sulhanfuadi/kawan-tunanetra/katana/katana.ino

/*
  KATANA (Kawan Tunanetra) - Smart Cane Prototype
  Target Board: Arduino Nano V3 (ATmega328P)

  Fitur Diagnosa Otomatis & Sensor Presence:
  - Mendeteksi secara langsung apakah sensor fisik terhubung (RIIL) atau terlepas (LEPAS).
  - Mencegah false alarm (misal alarm TEPI_TURUNAN tidak akan berbunyi jika sensor bawah memang belum dicolok).
  - Menampilkan status koneksi real-time setiap sensor di Serial Monitor.
*/

#include <Arduino.h>
#include <Wire.h>
#include <math.h>

// Set ke 0 untuk hardware fisik (Buzzer aktif 3-5V via transistor BC547)
// Set ke 1 jika simulasi di Wokwi
#define WOKWI_SIMULATION 0

// ================= PIN MAPPING =================
const byte PIN_FRONT_ECHO = 2;    // HC-SR04 Depan Echo
const byte PIN_FRONT_TRIG = 3;    // HC-SR04 Depan Trig
const byte PIN_FALL_TEST  = 4;    // Wokwi test button (D4 ke GND)
const byte PIN_VIBRATION  = 5;    // PWM Motor Getar SIG
const byte PIN_BUZZER     = 6;    // Active Buzzer via BC547 base
const byte PIN_DOWN_ECHO  = 8;    // HC-SR04 Bawah Echo
const byte PIN_DOWN_TRIG  = 9;    // HC-SR04 Bawah Trig
const byte PIN_WATER_RAW  = A0;   // Sensor Air Analog (A0)

const byte DEFAULT_MPU_ADDR = 0x68;   // Alamat I2C MPU6050 default (A4=SDA, A5=SCL)

// ================= PARAMETER AMBANG =================
const int FRONT_LOW_CM        = 100;
const int FRONT_MEDIUM_CM     = 60;
const int FRONT_NEAR_CM       = 30;
const int DOWN_DROP_THRESHOLD_CM = 45; // Ambang batas langsung sensor ke tanah (normal lantai ~25-38 cm, turunan/lubang > 45 cm)
const int WATER_LIMIT         = 400; // Diset ke 400 sesuai kalibrasi pengguna (ADC > 400 dianggap basah)
const float FALL_TILT_LIMIT_DEG = 45.0;
const unsigned long DROP_DEBOUNCE_MS = 200;
const unsigned long FALL_CONFIRM_MS  = 1200;

// Volume Buzzer PWM (0 - 255): Default 35 (~15% duty cycle, suara lembut dan tidak memekakkan telinga)
byte buzzerVolumePwm = 35;

enum AlertState {
  STANDBY,        // Sensor utama belum terpasang
  NORMAL,         // Semua sensor terpasang dan dalam batas aman
  OBJECT_LOW,     // Objek depan mulai terdeteksi (waspada)
  OBJECT_MEDIUM,  // Objek depan sedang
  OBJECT_NEAR,    // Objek depan sangat dekat (bahaya)
  WATER_ALERT,    // Genangan air / permukaan basah
  DROP_ALERT,     // Tepi turunan / lubang
  FALL_ALERT      // Tongkat jatuh / tergeletak
};

AlertState activeState = STANDBY;
unsigned long dropStartMs = 0;
unsigned long fallStartMs = 0;
unsigned long lastReportMs = 0;

// Data sensor & status koneksi hardware
bool frontConnected = false;
bool downConnected  = false;
bool mpuConnected   = false;
bool waterConnected = false;

// Konfigurasi Sensor Air Fisik (Pin A0)
// Diaktifkan default agar langsung membaca sensor air fisik tanpa perlu ketik WATER ON
bool waterSensorInstalled = true;

float frontCm = -1.0;
float downCm  = -1.0;
int waterValue = 0;
float tiltDeg = -1.0;

bool dropConfirmed  = false;
bool fallConfirmed  = false;
bool vibrationOn    = false;

// Mode Simulasi / Override Serial (seperti di Wokwi)
bool demoMode       = false;
float simFrontCm    = 80.0;
float simDownCm     = 30.0;
float simTiltDeg    = 12.0;
int simWaterVal     = 220;
String serialBuffer = "";

// Manual Override / Uji Aktuator Terpisah
bool overrideMotor = false;
byte manualMotorPwm = 0;
unsigned long overrideMotorUntilMs = 0;
AlertState testPatternState = NORMAL;
unsigned long overridePatternUntilMs = 0;

bool overrideBuzzer = false;
bool manualBuzzerState = false;
unsigned long overrideBuzzerUntilMs = 0;
bool buzzerMuted = false; // Mode Senyap: Mematikan suara buzzer fisik untuk kemudahan debug
bool motorMuted = false;  // Mode Senyap: Mematikan getaran motor fisik untuk kemudahan debug

void processSerialCommand(String cmd);
void checkSerialInput();
void driveMotor(byte pwm);
void driveBuzzer(bool on);
void selfTest();

byte mpuAddr = DEFAULT_MPU_ADDR;   // Alamat I2C MPU6050 dinamis (0x68 atau 0x69)
bool frontPinsInverted = false;    // Status apakah pin Trig/Echo depan tertukar
bool downPinsInverted = false;     // Status apakah pin Trig/Echo bawah tertukar

// Vektor Kalibrasi Fisik Tongkat Tegak (0.0° Plumb Zero)
// Dihitung langsung dari data sensor riil pengguna: X=1.08, Y=-0.04, Z=0.99
const float REF_X = 0.737f;
const float REF_Y = -0.027f;
const float REF_Z = 0.676f;

bool writeMPU(byte reg, byte value) {
  Wire.beginTransmission(mpuAddr);
  Wire.write(reg);
  Wire.write(value);
  byte err = Wire.endTransmission(true);
  return (err == 0);
}

// Prosedur pembersihan bus I2C ATmega328P jika SDA ditahan LOW oleh slave yang macet
void recoverI2CBus() {
  pinMode(A4, INPUT_PULLUP); // SDA
  pinMode(A5, OUTPUT);       // SCL
  
  // Kirim 9 clock pulse di SCL untuk release SDA jika slave sedang stuck
  for (byte i = 0; i < 9; i++) {
    digitalWrite(A5, HIGH);
    delayMicroseconds(10);
    digitalWrite(A5, LOW);
    delayMicroseconds(10);
  }
  
  // Generate STOP condition
  pinMode(A4, OUTPUT);
  digitalWrite(A4, LOW);
  delayMicroseconds(10);
  digitalWrite(A5, HIGH);
  delayMicroseconds(10);
  digitalWrite(A4, HIGH);
  delayMicroseconds(10);
  
  pinMode(A4, INPUT);
  pinMode(A5, INPUT);
  Wire.begin();
  Wire.setClock(100000);
}

byte scanI2C() {
  Wire.begin();
  Wire.setClock(100000);
  #if defined(WIRE_HAS_TIMEOUT)
    Wire.setWireTimeout(3000, true);
  #endif

  // Cek 0x68 (Default AD0 GND/Float)
  Wire.beginTransmission(0x68);
  if (Wire.endTransmission() == 0) return 0x68;

  // Cek 0x69 (AD0 VCC/Pull-up)
  Wire.beginTransmission(0x69);
  if (Wire.endTransmission() == 0) return 0x69;

  // Scan seluruh rentang alamat
  for (byte a = 1; a < 127; a++) {
    Wire.beginTransmission(a);
    if (Wire.endTransmission() == 0) return a;
  }

  // Jika belum terdeteksi, coba jalankan bus recovery untuk melepas slave yang terkunci
  recoverI2CBus();
  Wire.beginTransmission(0x68);
  if (Wire.endTransmission() == 0) return 0x68;
  Wire.beginTransmission(0x69);
  if (Wire.endTransmission() == 0) return 0x69;

  for (byte a = 1; a < 127; a++) {
    Wire.beginTransmission(a);
    if (Wire.endTransmission() == 0) return a;
  }

  return 0; // Tidak ada satupun perangkat I2C merespons
}

bool setupMPU() {
  byte detected = scanI2C();
  if (detected == 0) {
    return false; // Jalur I2C tidak merespons
  }
  mpuAddr = detected;

  bool okWake  = writeMPU(0x6B, 0x00); // Wake MPU6050 dari sleep mode
  delay(15);
  bool okAccel = writeMPU(0x1C, 0x00); // Accelerometer range +/-2g
  return (okWake && okAccel);
}

bool readMPUAccel(float &ax, float &ay, float &az) {
  Wire.beginTransmission(mpuAddr);
  Wire.write(0x3B);
  if (Wire.endTransmission(false) != 0) {
    // Fallback: Beberapa modul klon menolak repeated start, coba dengan true (STOP condition)
    Wire.beginTransmission(mpuAddr);
    Wire.write(0x3B);
    if (Wire.endTransmission(true) != 0) return false;
  }
  if (Wire.requestFrom((int)mpuAddr, 6, true) != 6) return false;

  int16_t rawX = (Wire.read() << 8) | Wire.read();
  int16_t rawY = (Wire.read() << 8) | Wire.read();
  int16_t rawZ = (Wire.read() << 8) | Wire.read();
  ax = rawX / 16384.0f;
  ay = rawY / 16384.0f;
  az = rawZ / 16384.0f;
  return true;
}

// Mengembalikan jarak cm jika tersambung, atau -1.0 jika timeout/lepas
float readUltrasonicCm(byte trigPin, byte echoPin, bool &connected) {
  digitalWrite(trigPin, LOW);
  delayMicroseconds(2);
  digitalWrite(trigPin, HIGH);
  delayMicroseconds(10);
  digitalWrite(trigPin, LOW);

  unsigned long pulse = pulseIn(echoPin, HIGH, 25000UL);
  if (pulse == 0) {
    connected = false;
    return -1.0;
  }
  connected = true;
  return pulse / 58.0;
}

// Pembacaan cerdas sensor depan dengan deteksi otomatis jika kabel Trig(D3) & Echo(D2) tertukar
float readFrontUltrasonic(bool &connected) {
  if (!frontPinsInverted) {
    float val = readUltrasonicCm(PIN_FRONT_TRIG, PIN_FRONT_ECHO, connected);
    if (connected) return val;

    // Coba uji coba apakah pin D2 dan D3 tertukar secara fisik
    pinMode(PIN_FRONT_ECHO, OUTPUT);
    pinMode(PIN_FRONT_TRIG, INPUT);
    float invVal = readUltrasonicCm(PIN_FRONT_ECHO, PIN_FRONT_TRIG, connected);
    if (connected) {
      frontPinsInverted = true;
      Serial.println(F("[AUTO-DETECT] Sensor Depan: Pin D2 dan D3 terpasang terbalik. Auto-swap aktif."));
      return invVal;
    }
    // Jika tetap gagal, kembalikan konfigurasi semula
    pinMode(PIN_FRONT_TRIG, OUTPUT);
    pinMode(PIN_FRONT_ECHO, INPUT);
    connected = false;
    return -1.0;
  } else {
    // Mode inverted aktif
    float val = readUltrasonicCm(PIN_FRONT_ECHO, PIN_FRONT_TRIG, connected);
    if (connected) return val;

    // Uji apakah sudah dibalikkan ke normal oleh pengguna
    pinMode(PIN_FRONT_TRIG, OUTPUT);
    pinMode(PIN_FRONT_ECHO, INPUT);
    float normVal = readUltrasonicCm(PIN_FRONT_TRIG, PIN_FRONT_ECHO, connected);
    if (connected) {
      frontPinsInverted = false;
      return normVal;
    }
    pinMode(PIN_FRONT_ECHO, OUTPUT);
    pinMode(PIN_FRONT_TRIG, INPUT);
    connected = false;
    return -1.0;
  }
}

// Pembacaan cerdas sensor bawah dengan deteksi otomatis jika kabel Trig(D9) & Echo(D8) tertukar
float readDownUltrasonic(bool &connected) {
  if (!downPinsInverted) {
    float val = readUltrasonicCm(PIN_DOWN_TRIG, PIN_DOWN_ECHO, connected);
    if (connected) return val;

    // Coba uji coba apakah pin D8 dan D9 tertukar secara fisik
    pinMode(PIN_DOWN_ECHO, OUTPUT);
    pinMode(PIN_DOWN_TRIG, INPUT);
    float invVal = readUltrasonicCm(PIN_DOWN_ECHO, PIN_DOWN_TRIG, connected);
    if (connected) {
      downPinsInverted = true;
      Serial.println(F("[AUTO-DETECT] Sensor Bawah: Pin D8 dan D9 terpasang terbalik. Auto-swap aktif."));
      return invVal;
    }
    // Jika tetap gagal, kembalikan konfigurasi semula
    pinMode(PIN_DOWN_TRIG, OUTPUT);
    pinMode(PIN_DOWN_ECHO, INPUT);
    connected = false;
    return -1.0;
  } else {
    // Mode inverted aktif
    float val = readUltrasonicCm(PIN_DOWN_ECHO, PIN_DOWN_TRIG, connected);
    if (connected) return val;

    // Uji apakah sudah dibalikkan ke normal oleh pengguna
    pinMode(PIN_DOWN_TRIG, OUTPUT);
    pinMode(PIN_DOWN_ECHO, INPUT);
    float normVal = readUltrasonicCm(PIN_DOWN_TRIG, PIN_DOWN_ECHO, connected);
    if (connected) {
      downPinsInverted = false;
      return normVal;
    }
    pinMode(PIN_DOWN_ECHO, OUTPUT);
    pinMode(PIN_DOWN_TRIG, INPUT);
    connected = false;
    return -1.0;
  }
}

void checkDownSensorBoot() {
  bool isConn = false;
  float val = readDownUltrasonic(isConn);
  if (isConn && val > 0) {
    Serial.print(F("OK (Jarak Permukaan Awal: "));
    Serial.print(val, 0);
    Serial.println(F(" cm)"));
  } else {
    Serial.println(F("SIAP (Menunggu pantulan lantai)"));
  }
}

void processSerialCommand(String cmd) {
  cmd.trim();
  if (cmd.length() == 0) return;

  String upper = cmd;
  upper.toUpperCase();

  if (upper == "HELP" || upper == "?") {
    Serial.println(F("[KATANA] DEMO ON/OFF, FALL, DROP, WET, NORMAL, FRONT <cm>, DOWN <cm>, TILT <deg>, TEST MOTOR, TEST BUZZER, TEST IMU"));
    return;
  }

  if (upper == "DEMO ON" || upper == "DEMO:ON" || upper == "SIM 1" || upper == "SIM ON") {
    demoMode = true;
    Serial.println(F("[SISTEM] >>> MODE DEMO AKTIF: Nilai sensor di-override via serial <<<"));
    return;
  }

  if (upper == "DEMO OFF" || upper == "DEMO:OFF" || upper == "SIM 0" || upper == "SIM OFF") {
    demoMode = false;
    Serial.println(F("[SISTEM] >>> MODE DEMO NONAKTIF: Kembali membaca sensor fisik <<<"));
    return;
  }

  if (upper == "WATER ON" || upper == "WATER:ON") {
    waterSensorInstalled = true;
    Serial.println(F("[SENSOR] Sensor Air A0 DIAKTIFKAN."));
    return;
  }

  if (upper == "WATER OFF" || upper == "WATER:OFF") {
    waterSensorInstalled = false;
    waterConnected = false;
    waterValue = 0;
    Serial.println(F("[SENSOR] Sensor Air A0 DINONAKTIFKAN (Status: LEPAS)."));
    return;
  }

  if (upper == "FALL" || upper == "DEMO:FALL") {
    demoMode = true;
    simTiltDeg = 75.0;
    Serial.println(F("[SISTEM] PRESET AKTIF: Tongkat Terjatuh (Kemiringan 75°)"));
    return;
  }

  if (upper == "DROP" || upper == "DEMO:DROP") {
    demoMode = true;
    simDownCm = 60.0;
    simTiltDeg = 15.0;
    Serial.println(F("[SISTEM] PRESET AKTIF: Tepi Turunan / Lubang (Jarak Bawah 60 cm > ambang 45 cm)"));
    return;
  }

  if (upper == "WET" || upper == "WATER_ALERT" || upper == "DEMO:WET") {
    demoMode = true;
    simWaterVal = 850;
    Serial.println(F("[SISTEM] PRESET AKTIF: Genangan Air (Nilai 850)"));
    return;
  }

  if (upper == "NEAR" || upper == "DEMO:NEAR") {
    demoMode = true;
    simFrontCm = 15.0;
    Serial.println(F("[SISTEM] PRESET AKTIF: Rintangan Depan Sangat Dekat (15cm)"));
    return;
  }

  if (upper == "DIAG" || upper == "CHECK" || upper == "TEST ALL" || upper == "TEST:ALL") {
    Serial.println(F("\n--- [HASIL DIAGNOSA KONEKSI SENSOR FISIK] ---"));
    
    // Test 1: Depan
    bool connF = false;
    float distF = readFrontUltrasonic(connF);
    Serial.print(F("1. Sensor Depan (D2/D3): "));
    if (connF) {
      Serial.print(F("TERHUBUNG (Jarak: ")); Serial.print(distF, 1); Serial.print(F(" cm)"));
      if (frontPinsInverted) Serial.print(F(" [PIN D2/D3 TERBALIK AUTO-SWAPPED]"));
      Serial.println();
    } else {
      Serial.println(F("LEPAS (Echo timeout. Coba tukar pin D2 & D3 atau cek VCC 5V)"));
    }

    // Test 2: Bawah
    bool connD = false;
    float distD = readDownUltrasonic(connD);
    Serial.print(F("2. Sensor Bawah (D8/D9): "));
    if (connD) {
      Serial.print(F("TERHUBUNG (Jarak: ")); Serial.print(distD, 1); Serial.print(F(" cm)"));
      if (downPinsInverted) Serial.print(F(" [PIN D8/D9 TERBALIK AUTO-SWAPPED]"));
      Serial.println();
    } else {
      Serial.println(F("LEPAS / KABEL TIDAK MERESPONS (Echo timeout 25ms)"));
    }

    // Test 3: MPU6050
    Serial.print(F("3. Sensor IMU MPU6050 (A4/A5 I2C): "));
    byte i2cAddr = scanI2C();
    if (i2cAddr != 0) {
      mpuAddr = i2cAddr;
      setupMPU(); // Bangunkan dari mode sleep
      float ax, ay, az;
      if (readMPUAccel(ax, ay, az)) {
        Serial.print(F("TERHUBUNG pada 0x")); Serial.print(i2cAddr, HEX);
        Serial.print(F(" (Accel X [Batang Vertikal]: ")); Serial.print(ax, 2); Serial.println(F("g)"));
      } else {
        Serial.print(F("ALAMAT 0x")); Serial.print(i2cAddr, HEX); Serial.println(F(" MERESPONS TAPI GAGAL BACA DATA"));
      }
    } else {
      Serial.println(F("LEPAS (Tidak ada perangkat I2C). Cek: 1. Pin header sudah disolder? 2. SDA ke A4, SCL ke A5 3. VCC ke 5V"));
    }

    // Test 4: Sensor Air
    int wVal = analogRead(PIN_WATER_RAW);
    Serial.print(F("4. Sensor Air (A0): "));
    Serial.print(F("ADC RAW = ")); Serial.print(wVal);
    if (wVal < 50) Serial.println(F(" (Kering / Mengambang)"));
    else if (wVal > 650) Serial.println(F(" (Basah Terdeteksi)"));
    else Serial.println(F(" (Lembab Sedang)"));

    Serial.println(F("--------------------------------------------\n"));
    return;
  }

  if (upper == "TEST FRONT" || upper == "TEST:FRONT") {
    bool conn = false;
    float d = readFrontUltrasonic(conn);
    Serial.print(F("[TEST SENSOR DEPAN] "));
    if (conn) {
      Serial.print(F("TERHUBUNG -> Jarak = ")); Serial.print(d, 1); Serial.print(F(" cm"));
      if (frontPinsInverted) Serial.print(F(" (Pin D2/D3 terbalik, auto-swapped)"));
      Serial.println();
    } else {
      Serial.println(F("LEPAS -> Echo timeout. Coba tukar kabel pin D2 dan D3, serta pastikan VCC dapat 5V!"));
    }
    return;
  }

  if (upper == "TEST DOWN" || upper == "TEST:DOWN") {
    bool conn = false;
    float d = readDownUltrasonic(conn);
    Serial.print(F("[TEST SENSOR BAWAH] "));
    if (conn) {
      Serial.print(F("TERHUBUNG -> Jarak = ")); Serial.print(d, 1); Serial.print(F(" cm"));
      if (downPinsInverted) Serial.print(F(" (Pin D8/D9 terbalik, auto-swapped)"));
      Serial.println();
    } else {
      Serial.println(F("LEPAS -> Tidak ada pulsa echo dari pin D8. Cek kabel VCC, GND, D8, D9!"));
    }
    return;
  }

  if (upper == "TEST IMU" || upper == "TEST:IMU" || upper == "TEST MPU") {
    float ax, ay, az;
    if (readMPUAccel(ax, ay, az)) {
      float mag = sqrt(ax * ax + ay * ay + az * az);
      float dot = (mag > 0.05) ? (ax * REF_X + ay * REF_Y + az * REF_Z) / mag : 1.0f;
      float tilt = acos(constrain(fabs(dot), 0.0f, 1.0f)) * 180.0 / PI;
      Serial.print(F("[IMU] X=")); Serial.print(ax, 2);
      Serial.print(F(" Y=")); Serial.print(ay, 2);
      Serial.print(F(" Z=")); Serial.print(az, 2);
      Serial.print(F(" -> Tilt=")); Serial.print(tilt, 1); Serial.println(F("°"));
    } else {
      Serial.println(F("[IMU] Gagal baca I2C"));
    }
    return;
  }

  if (upper == "TEST WATER" || upper == "TEST:WATER") {
    if (!waterSensorInstalled) {
      Serial.println(F("[TEST SENSOR AIR A0] Sensor Air DINONAKTIFKAN / BELUM DIPASANG di Pin A0 (Ketik 'WATER ON' jika sudah dipasang)."));
      return;
    }
    int val = analogRead(PIN_WATER_RAW);
    Serial.print(F("[TEST SENSOR AIR A0] Terbaca ADC: "));
    Serial.print(val);
    Serial.println(val > 650 ? F(" -> BASAH") : F(" -> KERING"));
    return;
  }

  // ================= UJI SIMULASI & TRIGGER AKTUATOR =================
  if (upper == "TEST MOTOR" || upper == "TEST:MOTOR" || upper == "VIBE" || upper == "GETAR") {
    overridePatternUntilMs = 0;
    overrideMotorUntilMs = millis() + 2000;
    manualMotorPwm = 255;
    Serial.println(F("[UJI AKTUATOR] Motor Getar AKTIF Tenaga Penuh (PWM 255) selama 2.0 detik di Pin D5..."));
    return;
  }

  if (upper == "TEST VIBE 3" || upper == "TEST VIBE:3" || upper == "TEST VIBE DROP" || upper == "VIBE 3" || upper == "GETAR 3") {
    overrideMotorUntilMs = 0;
    testPatternState = DROP_ALERT;
    overridePatternUntilMs = millis() + 4800; // 3 siklus lengkap (4.8 detik)
    Serial.println(F("[UJI POLA GETAR] Menguji Pola Burst 3-3-3 (Tepi Turunan/Lubang) Tenaga Penuh (PWM 255) selama 4.8 detik..."));
    return;
  }

  if (upper == "TEST VIBE 2" || upper == "TEST VIBE:2" || upper == "TEST VIBE WATER" || upper == "VIBE 2" || upper == "GETAR 2") {
    overrideMotorUntilMs = 0;
    testPatternState = WATER_ALERT;
    overridePatternUntilMs = millis() + 5400; // 3 siklus lengkap (5.4 detik)
    Serial.println(F("[UJI POLA GETAR] Menguji Pola Ganda 2-2-2 (Genangan Air/Basah) Tenaga Penuh (PWM 255) selama 5.4 detik..."));
    return;
  }

  if (upper == "TEST VIBE 1" || upper == "TEST VIBE:1" || upper == "TEST VIBE LOW" || upper == "VIBE 1" || upper == "GETAR 1") {
    overrideMotorUntilMs = 0;
    testPatternState = OBJECT_LOW;
    overridePatternUntilMs = millis() + 4000; // 4 siklus (4.0 detik)
    Serial.println(F("[UJI POLA GETAR] Menguji Pola Tunggal Tek 1-1 (Jarak Jauh 60-100cm) Tenaga Penuh (PWM 255) selama 4.0 detik..."));
    return;
  }

  if (upper == "TEST VIBE MED" || upper == "TEST VIBE:MED" || upper == "VIBE MED") {
    overrideMotorUntilMs = 0;
    testPatternState = OBJECT_MEDIUM;
    overridePatternUntilMs = millis() + 4000;
    Serial.println(F("[UJI POLA GETAR] Menguji Pola Cepat & Rapat (Jarak Sedang 30-60cm) Tenaga Penuh (PWM 255) selama 4.0 detik..."));
    return;
  }

  if (upper == "TEST VIBE NEAR" || upper == "TEST VIBE:NEAR" || upper == "TEST VIBE PANJER" || upper == "VIBE NEAR") {
    overrideMotorUntilMs = 0;
    testPatternState = OBJECT_NEAR;
    overridePatternUntilMs = millis() + 3000;
    Serial.println(F("[UJI POLA GETAR] Menguji Pola Panjer Kontinu (Jarak Dekat <30cm) Tenaga Penuh (PWM 255) selama 3.0 detik..."));
    return;
  }

  if (upper == "MOTOR ON" || upper == "MOTOR:ON") {
    overridePatternUntilMs = 0;
    overrideMotor = true;
    manualMotorPwm = 255;
    overrideMotorUntilMs = 0;
    Serial.println(F("[UJI AKTUATOR] Motor Getar DINYALAKAN Penuh (PWM 255) (Ketik MOTOR OFF untuk mematikan)."));
    return;
  }

  if (upper == "MOTOR OFF" || upper == "MOTOR:OFF") {
    overridePatternUntilMs = 0;
    overrideMotor = false;
    manualMotorPwm = 0;
    overrideMotorUntilMs = 0;
    analogWrite(PIN_VIBRATION, 0);
    Serial.println(F("[UJI AKTUATOR] Motor Getar DIMATIKAN."));
    return;
  }

  if (upper == "TEST BUZZER" || upper == "TEST:BUZZER" || upper == "BEEP" || upper == "BUNYI") {
    overrideBuzzerUntilMs = millis() + 1500;
    Serial.println(F("[UJI AKTUATOR] Buzzer AKTIF pola Beep selama 1.5 detik di Pin D6..."));
    return;
  }

  if (upper == "BUZZER ON" || upper == "BUZZER:ON") {
    overrideBuzzer = true;
    manualBuzzerState = true;
    overrideBuzzerUntilMs = 0;
    driveBuzzer(true);
    Serial.println(F("[UJI AKTUATOR] Buzzer DINYALAKAN terus-menerus (Ketik BUZZER OFF untuk mematikan)."));
    return;
  }

  if (upper == "BUZZER OFF" || upper == "BUZZER:OFF") {
    overrideBuzzer = false;
    manualBuzzerState = false;
    overrideBuzzerUntilMs = 0;
    driveBuzzer(false);
    Serial.println(F("[UJI AKTUATOR] Buzzer DIMATIKAN."));
    return;
  }

  if (upper == "MUTE" || upper == "MUTE ON" || upper == "MUTE:ON" || upper == "MUTE 1" || upper == "BUZZER MUTE" || upper == "SILENT") {
    buzzerMuted = true;
    driveBuzzer(false);
    Serial.println(F("[BUZZER] MODE SENYAP DIAKTIFKAN: Buzzer fisik dimatikan untuk debug (Ketik MUTE OFF untuk mengaktifkan kembali)."));
    return;
  }

  if (upper == "UNMUTE" || upper == "MUTE OFF" || upper == "MUTE:OFF" || upper == "MUTE 0" || upper == "BUZZER UNMUTE" || upper == "LOUD") {
    buzzerMuted = false;
    Serial.println(F("[BUZZER] MODE SENYAP DIMATIKAN: Suara buzzer diaktifkan kembali."));
    return;
  }

  if (upper == "MUTE TOGGLE" || upper == "BUZZER TOGGLE") {
    buzzerMuted = !buzzerMuted;
    if (buzzerMuted) driveBuzzer(false);
    Serial.print(F("[BUZZER] Status Mode Senyap: "));
    Serial.println(buzzerMuted ? F("AKTIF (MUTED)") : F("NONAKTIF (UNMUTED)"));
    return;
  }

  if (upper == "MUTE MOTOR" || upper == "MUTE MOTOR ON" || upper == "MUTE:MOTOR" || upper == "MOTOR MUTE" || upper == "MOTOR MUTE ON" || upper == "MUTE VIB" || upper == "VIB MUTE" || upper == "SILENT MOTOR") {
    motorMuted = true;
    analogWrite(PIN_VIBRATION, 0);
    Serial.println(F("[MOTOR] MODE SENYAP GETAR DIAKTIFKAN: Motor getar fisik dimatikan untuk debug (Ketik MUTE MOTOR OFF untuk mengaktifkan kembali)."));
    return;
  }

  if (upper == "UNMUTE MOTOR" || upper == "MUTE MOTOR OFF" || upper == "MOTOR MUTE OFF" || upper == "MOTOR UNMUTE" || upper == "UNMUTE VIB" || upper == "VIB UNMUTE" || upper == "LOUD MOTOR") {
    motorMuted = false;
    Serial.println(F("[MOTOR] MODE SENYAP GETAR DIMATIKAN: Getaran motor diaktifkan kembali."));
    return;
  }

  if (upper == "MUTE MOTOR TOGGLE" || upper == "MOTOR MUTE TOGGLE" || upper == "MOTOR TOGGLE" || upper == "VIB TOGGLE") {
    motorMuted = !motorMuted;
    if (motorMuted) analogWrite(PIN_VIBRATION, 0);
    Serial.print(F("[MOTOR] Status Mode Senyap Getar: "));
    Serial.println(motorMuted ? F("AKTIF (MUTED)") : F("NONAKTIF (UNMUTED)"));
    return;
  }

  if (upper == "MUTE ALL" || upper == "SILENT ALL" || upper == "MUTE:ALL") {
    buzzerMuted = true;
    motorMuted = true;
    driveBuzzer(false);
    analogWrite(PIN_VIBRATION, 0);
    Serial.println(F("[AKTUATOR] SEMUA AKTUATOR SENYAP: Buzzer & Motor getar dimatikan untuk debug."));
    return;
  }

  if (upper == "UNMUTE ALL" || upper == "LOUD ALL" || upper == "UNMUTE:ALL") {
    buzzerMuted = false;
    motorMuted = false;
    Serial.println(F("[AKTUATOR] SEMUA AKTUATOR AKTIF: Buzzer & Motor getar diaktifkan kembali."));
    return;
  }

  if (upper == "TEST OUTPUT" || upper == "TEST ACTUATOR" || upper == "TEST ACTUATORS" || upper == "TEST:ACTUATORS") {
    Serial.println(F("[UJI AKTUATOR] Memulai Self-Test Semua Aktuator: Motor getar lalu Buzzer..."));
    selfTest();
    Serial.println(F("[UJI AKTUATOR] Uji coba aktuator selesai!"));
    return;
  }

  if (upper == "STOP" || upper == "ACTUATOR OFF" || upper == "OUTPUT OFF") {
    overrideMotor = false;
    manualMotorPwm = 0;
    overrideMotorUntilMs = 0;
    overridePatternUntilMs = 0;
    analogWrite(PIN_VIBRATION, 0);

    overrideBuzzer = false;
    manualBuzzerState = false;
    overrideBuzzerUntilMs = 0;
    driveBuzzer(false);
    Serial.println(F("[UJI AKTUATOR] Semua aktuator manual DIMATIKAN."));
    return;
  }

  if (upper == "NORMAL" || upper == "RESET" || upper == "DEMO:NORMAL") {
    demoMode = false;
    overridePatternUntilMs = 0;
    simFrontCm = 120.0;
    simDownCm = 30.0;
    simTiltDeg = 12.0;
    simWaterVal = 180;
    Serial.println(F("[SISTEM] KEMBALI KE SENSOR FISIK ASLI"));
    return;
  }

  // Handle format: DEMO:KEY=VAL atau KEY=VAL atau KEY VAL
  if (upper.startsWith("DEMO:")) {
    upper = upper.substring(5);
  }

  int sep = upper.indexOf('=');
  if (sep == -1) sep = upper.indexOf(' ');
  if (sep != -1) {
    String key = upper.substring(0, sep);
    key.trim();
    String valStr = upper.substring(sep + 1);
    valStr.trim();
    float val = valStr.toFloat();

    demoMode = true; // Otomatis aktifkan demo jika ada nilai yang diset

    if (key == "FRONT" || key == "DEPAN") {
      simFrontCm = val;
      Serial.print(F("[SIM] Jarak Depan diset ke: "));
      Serial.print(simFrontCm, 0);
      Serial.println(F(" cm"));
    } else if (key == "DOWN" || key == "BAWAH") {
      simDownCm = val;
      Serial.print(F("[SIM] Jarak Bawah diset ke: "));
      Serial.print(simDownCm, 0);
      Serial.println(F(" cm"));
    } else if (key == "TILT" || key == "SUDUT") {
      simTiltDeg = val;
      Serial.print(F("[SIM] Kemiringan diset ke: "));
      Serial.print(simTiltDeg, 1);
      Serial.println(F("°"));
    } else if (key == "WATER" || key == "AIR") {
      simWaterVal = (int)val;
      Serial.print(F("[SIM] Sensor Air diset ke: "));
      Serial.println(simWaterVal);
    } else if (key == "VOL" || key == "VOLUME") {
      buzzerVolumePwm = (byte)constrain((int)val, 5, 255);
      Serial.print(F("[AUDIO] Volume Buzzer diset ke PWM: "));
      Serial.print(buzzerVolumePwm);
      Serial.print(F("/255 (~"));
      Serial.print((buzzerVolumePwm * 100) / 255);
      Serial.println(F("%)"));
    }
  }
}

void checkSerialInput() {
  while (Serial.available()) {
    char c = (char)Serial.read();
    if (c == '\n' || c == '\r') {
      if (serialBuffer.length() > 0) {
        processSerialCommand(serialBuffer);
        serialBuffer = "";
      }
    } else {
      if (serialBuffer.length() < 64) {
        serialBuffer += c;
      }
    }
  }
}

void updateInputs() {
  checkSerialInput();

  unsigned long now = millis();
  
  if (demoMode) {
    // Mode Simulasi / Override Serial
    frontConnected = true;
    downConnected  = true;
    mpuConnected   = true;
    waterConnected = true;

    frontCm     = simFrontCm;
    downCm      = simDownCm;
    tiltDeg     = simTiltDeg;
    waterValue  = simWaterVal;
  } else {
    // Mode Fisik Nyata: Baca sensor fisik
    // 1. Baca sensor depan
    frontCm = readFrontUltrasonic(frontConnected);
    delayMicroseconds(2500); // Cegah cross-talk ultrasonik
    
    // 2. Baca sensor bawah (dengan deteksi otomatis pin D8/D9)
    downCm = readDownUltrasonic(downConnected);

    // 3. Baca sensor air (Pin A0)
    if (waterSensorInstalled) {
      waterValue = analogRead(PIN_WATER_RAW);
      waterConnected = true; // Selalu terhubung selama modul terpasang fisik
    } else {
      waterValue = 0;
      waterConnected = false;
    }

    // 4. Baca MPU6050 dengan auto re-detection jika sempat lepas
    float ax = 0.0, ay = 0.0, az = 1.0;
    if (mpuConnected) {
      if (readMPUAccel(ax, ay, az)) {
        float magnitude = sqrt(ax * ax + ay * ay + az * az);
        if (magnitude > 0.05) {
          float dot = (ax * REF_X + ay * REF_Y + az * REF_Z) / magnitude;
          float ratio = constrain(fabs(dot), 0.0f, 1.0f);
          tiltDeg = acos(ratio) * 180.0 / PI;
        }
      } else {
        mpuConnected = false;
        tiltDeg = -1.0;
      }
    } else {
      // Re-deteksi & inisialisasi ulang otomatis tiap 1.5 detik jika sensor baru dipasang/dicolok
      static unsigned long lastMpuRetryMs = 0;
      if (now - lastMpuRetryMs >= 1500) {
        lastMpuRetryMs = now;
        if (setupMPU()) {
          mpuConnected = true;
        }
      }
    }
  }

  // Filter deteksi turunan: HANYA aktif jika sensor bawah benar-benar TERHUBUNG (bukan lepas)
  // On-Point: Jarak langsung sensor ke permukaan bawah melebihi batas normal lantai (> 45 cm)
  bool dropCandidate = downConnected && (downCm > DOWN_DROP_THRESHOLD_CM);
  if (dropCandidate) {
    if (dropStartMs == 0) dropStartMs = now;
    dropConfirmed = (now - dropStartMs >= DROP_DEBOUNCE_MS);
  } else {
    dropStartMs = 0;
    dropConfirmed = false;
  }

  // Deteksi tongkat jatuh: HANYA aktif jika MPU6050 TERHUBUNG (kemiringan > 60 deg selama > 2 detik)
  bool fallButton = (digitalRead(PIN_FALL_TEST) == LOW);
  bool fallCandidate = mpuConnected && (tiltDeg > FALL_TILT_LIMIT_DEG);
  if (fallCandidate) {
    if (fallStartMs == 0) fallStartMs = now;
    fallConfirmed = (now - fallStartMs >= FALL_CONFIRM_MS);
  } else {
    fallStartMs = 0;
    fallConfirmed = false;
  }
  if (fallButton) fallConfirmed = true;
}

AlertState decideState() {
  // Jika seluruh sensor belum dicolok, tetap di mode STANDBY (cegah getar palsu)
  if (!frontConnected && !downConnected && !mpuConnected) {
    return STANDBY;
  }

  // Prioritas tunggal: Jatuh > Tepi Turunan > Genangan Air > Objek Depan
  if (fallConfirmed) return FALL_ALERT;
  if (dropConfirmed) return DROP_ALERT;
  if (waterConnected && waterValue > WATER_LIMIT) return WATER_ALERT;
  
  if (frontConnected) {
    if (frontCm < FRONT_NEAR_CM)   return OBJECT_NEAR;
    if (frontCm < FRONT_MEDIUM_CM) return OBJECT_MEDIUM;
    if (frontCm < FRONT_LOW_CM)    return OBJECT_LOW;
  }

  return NORMAL;
}

bool pulseWindow(unsigned long phase, unsigned long startMs, unsigned long endMs) {
  return phase >= startMs && phase < endMs;
}

bool vibrationPattern(AlertState state, unsigned long now) {
  switch (state) {
    case OBJECT_LOW:
      // Jarak Jauh (60-100cm): Denyut Tunggal Mantap ("tek 1 1")
      // 320ms getar penuh (PWM 255), 680ms jeda -> siklus 1000ms (1x ketukan kuat per detik di genggaman tangan)
      return (now % 1000UL) < 320UL;

    case OBJECT_MEDIUM:
      // Jarak Sedang (30-60cm): Denyut Cepat & Rapat ("tek... tek... tek...")
      // 260ms getar penuh, 220ms jeda -> siklus 480ms (ritme rapat yang terasa tegas dan jelas di telapak tangan)
      return (now % 480UL) < 260UL;

    case OBJECT_NEAR:
      // Jarak Sangat Dekat (<30cm): DI-PANJER KONTINU 100% NONSTOP tanpa jeda
      // Getaran maksimal penuh terus-menerus untuk bahaya tabrakan kritis di depan tubuh
      return true;

    case WATER_ALERT: {
      // Genangan Air / Permukaan Basah: 2 Denyut Panjang ("2 2 2" / Ganda Mantap)
      // Siklus 1800ms: 400ms Getar, 200ms Jeda, 400ms Getar, 800ms Istirahat
      // Terasa jelas dua gelombang getaran panjang menghentak telapak tangan tunanetra
      unsigned long p = now % 1800UL;
      return pulseWindow(p, 0, 400) || pulseWindow(p, 600, 1000);
    }

    case DROP_ALERT: {
      // Tepi Turunan / Lubang Jalan / Tangga: Burst 3 Denyut Menghentak Kuat ("3 3 3")
      // Siklus 1600ms: Tiga ketukan getar 220ms berselang jeda 120ms, lalu 700ms jeda istirahat
      // Di genggaman tangan terasa getaran tiga kali berturutan yang sangat tegas dan berkarakter
      unsigned long p = now % 1600UL;
      return pulseWindow(p, 0, 220) || pulseWindow(p, 340, 560) || pulseWindow(p, 680, 900);
    }

    default:
      return false;
  }
}

bool buzzerPattern(AlertState state, unsigned long now) {
  // 1. Alarm SOS Morse jika tongkat jatuh (Prioritas 1)
  if (state == FALL_ALERT) {
    // Pola SOS Morse (... --- ...)
    unsigned long p = now % 3600UL;
    return pulseWindow(p, 0, 140) || pulseWindow(p, 240, 380) || pulseWindow(p, 480, 620) ||
           pulseWindow(p, 820, 1220) || pulseWindow(p, 1340, 1740) || pulseWindow(p, 1860, 2260) ||
           pulseWindow(p, 2460, 2600) || pulseWindow(p, 2700, 2840) || pulseWindow(p, 2940, 3080);
  }

  // 2. Alarm Bip Cepat Audio jika rintangan depan sangat dekat (< 30cm / Kasus 4)
  if (state == OBJECT_NEAR) {
    return ((now / 100UL) % 2 == 0); // Beep staccato cepat 100ms ON / 100ms OFF
  }

  return false;
}

void driveMotor(byte pwm) {
  if (motorMuted) {
    analogWrite(PIN_VIBRATION, 0);
    return;
  }
  analogWrite(PIN_VIBRATION, pwm);
}

void driveBuzzer(bool on) {
  if (buzzerMuted) {
#if WOKWI_SIMULATION
    noTone(PIN_BUZZER);
#else
    analogWrite(PIN_BUZZER, 0);
#endif
    return;
  }
#if WOKWI_SIMULATION
  if (on) tone(PIN_BUZZER, 1000);
  else noTone(PIN_BUZZER);
#else
  // Gunakan PWM (analogWrite) untuk mengatur volume suara buzzer secara presisi
  if (on) {
    analogWrite(PIN_BUZZER, buzzerVolumePwm > 0 ? buzzerVolumePwm : 35);
  } else {
    analogWrite(PIN_BUZZER, 0);
  }
#endif
}

void updateOutputs(AlertState state) {
  unsigned long now = millis();

  // 1. Motor Getar: Cek apakah sedang dalam mode uji/override manual
  if (overrideMotorUntilMs > 0) {
    if (now < overrideMotorUntilMs) {
      vibrationOn = true;
      driveMotor(manualMotorPwm > 0 ? manualMotorPwm : 255);
    } else {
      overrideMotorUntilMs = 0;
      vibrationOn = false;
      driveMotor(0);
    }
  } else if (overridePatternUntilMs > 0) {
    if (now < overridePatternUntilMs) {
      vibrationOn = vibrationPattern(testPatternState, now);
      driveMotor(vibrationOn ? 255 : 0);
    } else {
      overridePatternUntilMs = 0;
      vibrationOn = false;
      driveMotor(0);
    }
  } else if (overrideMotor) {
    vibrationOn = (manualMotorPwm > 0);
    driveMotor(manualMotorPwm);
  } else {
    vibrationOn = vibrationPattern(state, now);
    // Tenaga getar penuh: PWM 255 (100% tegangan motor) untuk getaran yang jauh lebih terasa dan responsif
    driveMotor(vibrationOn ? 255 : 0);
  }

  // 2. Buzzer: Cek apakah sedang dalam mode uji/override manual
  if (overrideBuzzerUntilMs > 0) {
    if (now < overrideBuzzerUntilMs) {
      // Pola beep berselang-seling (150ms ON, 150ms OFF) agar jelas terdengar
      bool beep = ((now / 150) % 2 == 0);
      driveBuzzer(beep);
    } else {
      overrideBuzzerUntilMs = 0;
      driveBuzzer(false);
    }
  } else if (overrideBuzzer) {
    driveBuzzer(manualBuzzerState);
  } else {
    driveBuzzer(buzzerPattern(state, now));
  }
}

const __FlashStringHelper *stateName(AlertState state) {
  switch (state) {
    case STANDBY:       return F("STANDBY (Sensor Lepas)");
    case OBJECT_LOW:    return F("OBJEK_WASPADA");
    case OBJECT_MEDIUM: return F("OBJEK_SEDANG");
    case OBJECT_NEAR:   return F("OBJEK_DEKAT");
    case WATER_ALERT:   return F("PERMUKAAN_BASAH");
    case DROP_ALERT:    return F("TEPI_TURUNAN");
    case FALL_ALERT:    return F("TONGKAT_JATUH");
    default:            return F("NORMAL");
  }
}

void selfTest() {
  Serial.println(F("[UJI AKTUATOR] 1. Menguji Motor Getar (Pin D5 PWM)..."));
  driveMotor(220);
  delay(400);
  driveMotor(0);
  delay(200);

  Serial.println(F("[UJI AKTUATOR] 2. Menguji Buzzer (Pin D6)..."));
  driveBuzzer(true);
  delay(150);
  driveBuzzer(false);
  delay(100);
  driveBuzzer(true);
  delay(150);
  driveBuzzer(false);
}

void setup() {
  Serial.begin(115200);
  delay(100); // Beri jeda stabilisasi serial port
  Serial.println(F("\n[BOOT] Arduino Booting..."));
  Serial.println(F("[BOOT] Menginisialisasi Pin I/O..."));

  pinMode(PIN_FRONT_TRIG, OUTPUT);
  pinMode(PIN_FRONT_ECHO, INPUT);
  pinMode(PIN_DOWN_TRIG, OUTPUT);
  pinMode(PIN_DOWN_ECHO, INPUT);
  pinMode(PIN_FALL_TEST, INPUT_PULLUP);
  pinMode(PIN_VIBRATION, OUTPUT);
  pinMode(PIN_BUZZER, OUTPUT);

  // Inisialisasi dan diagnosa MPU6050
  Serial.print(F("[BOOT] Mengecek Sensor IMU MPU6050 (A4/A5)... "));
  bool mpuOk = setupMPU();
  if (mpuOk) {
    mpuConnected = true;
    Serial.print(F("OK (Terdeteksi di 0x"));
    Serial.print(mpuAddr, HEX);
    Serial.println(F(")"));
  } else {
    mpuConnected = false;
    Serial.println(F("LEPAS/GAGAL (Bus I2C A4/A5 tidak merespons)"));
  }

  // Diagnosa kesiapan sensor ultrasonik bawah (On-Point Surface Detection)
  Serial.print(F("[BOOT] Mengecek Sensor Bawah (Pin 8/9)... "));
  checkDownSensorBoot();

  // Uji aktuator getar dan buzzer
  Serial.print(F("[BOOT] Uji Coba Aktuator (Self-Test)... "));
  selfTest();
  Serial.println(F("OK"));

  Serial.println(F("=================================================="));
  Serial.println(F("      KATANA SMART CANE - SYSTEM ONLINE           "));
  Serial.println(F("  Ketik HELP di Serial Monitor untuk Mode Demo    "));
  Serial.println(F("=================================================="));
}

void loop() {
  updateInputs();
  activeState = decideState();
  updateOutputs(activeState);

  unsigned long now = millis();
  if (now - lastReportMs >= 400) {
    lastReportMs = now;

    if (demoMode) {
      // Telemetri Khusus Mode Simulasi / Override Serial
      Serial.print(F("[SIMULASI] "));
      Serial.print(F("Depan:SIM("));
      Serial.print(frontCm, 0);
      Serial.print(F("cm) "));

      Serial.print(F("| Bawah:SIM("));
      Serial.print(downCm, 0);
      Serial.print(F("cm) "));

      Serial.print(F("| IMU:SIM("));
      Serial.print(tiltDeg, 1);
      Serial.print(F("°) "));

      Serial.print(F("| Air:SIM("));
      Serial.print(waterValue);
      Serial.print(F(")"));
    } else {
      // Telemetri Hardware Fisik Riil
      Serial.print(F("[KONEKSI] "));
      
      // Sensor Depan
      Serial.print(F("Depan:"));
      if (frontConnected) {
        Serial.print(F("RIIL("));
        Serial.print(frontCm, 0);
        Serial.print(F("cm) "));
      } else {
        Serial.print(F("LEPAS "));
      }

      // Sensor Bawah
      Serial.print(F("| Bawah:"));
      if (downConnected) {
        Serial.print(F("RIIL("));
        Serial.print(downCm, 0);
        Serial.print(F("cm) "));
      } else {
        Serial.print(F("LEPAS "));
      }

      // MPU6050
      Serial.print(F("| IMU:"));
      if (mpuConnected) {
        Serial.print(F("RIIL("));
        Serial.print(tiltDeg, 1);
        Serial.print(F("°) "));
      } else {
        Serial.print(F("LEPAS "));
      }

      // Sensor Air
      Serial.print(F("| Air:"));
      if (waterConnected) {
        Serial.print(F("RIIL("));
        Serial.print(waterValue);
        Serial.print(waterValue > WATER_LIMIT ? F(")[BASAH] ") : F(")[KERING] "));
      } else {
        Serial.print(F("LEPAS "));
      }
    }

    // Status Keputusan & Aktuator Fisik
    Serial.print(F(" || STATE: "));
    Serial.print(stateName(activeState));
    Serial.print(F(" | Motor: "));
    Serial.print(vibrationOn ? F("ON") : F("OFF"));
    if (motorMuted) {
      Serial.print(F(" [MUTED]"));
    }
    Serial.print(F(" | Buzzer: "));
    if (activeState == FALL_ALERT) {
      Serial.print(F("SOS"));
    } else if (activeState == OBJECT_NEAR) {
      Serial.print(F("BEEP"));
    } else {
      Serial.print(F("DIAM"));
    }
    if (buzzerMuted) {
      Serial.println(F(" [MUTED]"));
    } else {
      Serial.println();
    }
  }
  delay(20);
}
