sulhanfuadi/kawan-tunanetra/(commit log)

2026-10-04 Add comprehensive sensor diagnostic test sketch
2026-10-04 Refactor diagnostic.ino into interactive sensor tester
    Replace the old wiring-check script with a full interactive KATANA sensor diagnostic suite. Adds a serial menu (115200) and individual tests for: HC-SR04 front/down, MPU6050 (I2C wake/read), water sensor (stat/min/max/avg), vibration motor (PWM patterns), buzzer (via BC547), and an I2C scanner. Implements a "test all" flow, improved human-readable output, helper I2C read/write functions, and robust retry/count logic. Removes the duplicate sensor_test.ino file. This change reorganizes diagnostics into modular functions and improves troubleshooting guidance in serial output.
    [diagnostic.ino]
2026-10-04 Fix diagnostic serial output strings
    Corrects malformed string literals in diagnostic/diagnostic.ino for the MPU6050 and water sensor status messages. This preserves the intended serial output text and prevents broken diagnostic display formatting without changing the underlying logic.
    [diagnostic.ino]
2026-10-07 fix(telemetry): sync downward sensor readout and handle disconnected water sensor
    [katana.ino]
2026-10-07 fix(dashboard): add auto-backup recovery, beforeunload guard, and utf-8 bom for csv export
2026-10-07 feat(dashboard): enhance UX with dynamic port refresh, browser compatibility notice, and actuator feedback
2026-10-07 feat(diagnostic): add comprehensive actuator testing for buzzer D6 and motor vibrator D5
    [katana.ino, sketch.ino, three_stage_diagnostic.ino]
2026-10-07 fix(diagnostic): declare missing actuatorCycleCount variable
    [three_stage_diagnostic.ino]
2026-10-07 feat(diagnostic): add stage 4 katana live simulation and clarify water sensor adc
2026-10-07 docs: restructure testing guide into case-by-case simulation manual
2026-10-07 fix: add i2c bus recovery and periodic auto wake-up for mpu6050
    [katana.ino]
2026-10-07 feat(diagnostic): add i2c bus recovery pulse and live voltage telemetry in imu test
2026-10-07 feat(telemetry): activate buzzer beep alarm on critical near obstacle (case 4)
    [katana.ino]
2026-10-07 feat(actuator): reduce buzzer loudness using configurable PWM volume control
    [katana.ino, three_stage_diagnostic.ino]
2026-10-07 feat(firmware): enable physical water sensor by default without requiring serial command
2026-10-07 fix(firmware): properly recognize dry water sensor as connected and show live KERING/BASAH telemetry
    [katana.ino]
2026-10-07 feat(actuator): boost motor power to PWM 255 and tighten tactile pulse intervals
    [katana.ino]
2026-10-07 fix(water): lower moisture threshold from 650 to 300 so damp sensor triggers wet alarm
    [katana.ino]
2026-10-07 fix(water): adjust moisture threshold to 400 for balanced puddle detection
    [katana.ino]
2026-10-08 feat: add sample trial telemetry datasets in archive folder
    [katana_telemetry_20261008_083000_simulasi_jalur_normal.csv, katana_telemetry_20261008_084500_simulasi_rintangan_turunan.csv, katana_telemetry_20261008_090000_simulasi_darurat_jatuh_sos.csv, katana_telemetry_20261008_091549.csv]
2026-10-08 feat(actuator): boost all motor vibration levels (210-255 PWM) and enhance tactile differentiation
    [katana.ino, three_stage_diagnostic.ino]
2026-10-08 feat(actuator): boost all active vibration patterns to 100% full power PWM 255
    [katana.ino, three_stage_diagnostic.ino]
2026-10-08 feat(imu): add 3d vector upright calibration tare and zeroing for vertical cane mounting
2026-10-08 feat(tilt): update fall threshold to 30 deg and hide 2d cad visualization card
2026-10-08 feat: enhance haptic vibration patterns with full pwm and distinct rhythmic cadences
    [katana.ino]
2026-10-08 fix: add forward declarations for driveBuzzer and selfTest to resolve IDE diagnostics
    [katana.ino]
2026-10-08 refactor: use DEFAULT_MPU_ADDR constant to avoid unused variable warning
    [katana.ino]
2026-10-08 chore: add telemetry archive CSV file
    [katana_telemetry_20261008_134159.csv]
2026-10-08 fix(dashboard): calibrate pixel-perfect SVG cursor tracking and wide aspect ratio for state chart
2026-10-09 chore(assets): add v2 system diagrams, schematics, and flowcharts
2026-10-09 docs: update README visual documentation with v2 diagrams and flowcharts
2026-10-10 feat: add DataVisualizer component and initial telemetry archive dataset
    [katana_telemetry_20261009_142745.csv]
2026-10-10 feat(actuator): add buzzer mute toggle for debugging in firmware and dashboard
    [katana.ino]
2026-10-10 refactor(firmware): switch drop detection from delta to direct surface distance
2026-10-10 feat(dashboard): create 3d cane imu visualizer and calibration component
2026-10-10 refactor(dashboard): display direct ground surface distance instead of delta offset
2026-10-10 feat(actuator): add motor vibration mute toggle for debugging in firmware and dashboard
    [katana.ino]
2026-10-10 docs(firmware): synchronize downward distance and wet sensor calibration thresholds
2026-10-10 docs(readme): update calibration thresholds in serial table and tech specs
2026-10-10 feat(dashboard): adjust imu sensor position to right side of cane and add swap axes control
2026-10-10 refactor(dashboard): align visualizer chart and kpi cards with direct ground distance
2026-10-10 refactor(dashboard): remove delta readout and update drop card gauge to direct ground scale
2026-10-10 feat(dashboard): add comprehensive cane posture and imu calibration suite
2026-10-10 feat(dashboard): implement direct 3d model drag-to-calibrate and auto-sync
2026-10-10 feat(dashboard): add 360-degree yaw rotation and align safety zones with forward pitch axis
2026-10-10 refactor(firmware): decouple IMU tilt angle from drop detection
2026-10-10 fix(dashboard): implement gimbal-free nested pivot rotation hierarchy and direct yaw sliders
2026-10-10 fix(imu): calibrate mpu6050 to front face at 70cm and map vertical axis to Ay
    [katana.ino, sketch.ino]
2026-10-10 fix(imu): calibrate cane longitudinal axis to Ax for omnidirectional fall detection
    [katana.ino, sketch.ino]
2026-10-10 fix(imu): swap X and Z axes to match physical sensor marking and add 3D vector calibration
    [katana.ino, sketch.ino]
2026-10-10 refactor(firmware): remove manual calibration commands to save flash memory and hardcode axis mapping
2026-10-10 fix(imu): restore unswapped raw register mapping and tune fall threshold to 50 deg
    [katana.ino, sketch.ino]
2026-10-10 fix(imu): calibrate upright reference vector to (0.737, -0.027, 0.676) for omnidirectional fall detection
    [katana.ino, sketch.ino]
2026-10-10 refactor(dashboard): strip IMU calibration suite and keep pure 3D cane orientation visualizer
2026-10-10 fix(imu): lower fall tilt threshold to 45 degrees
    [katana.ino, sketch.ino]
